caaf1021/Sala-Snoezelen/Sala.jpg

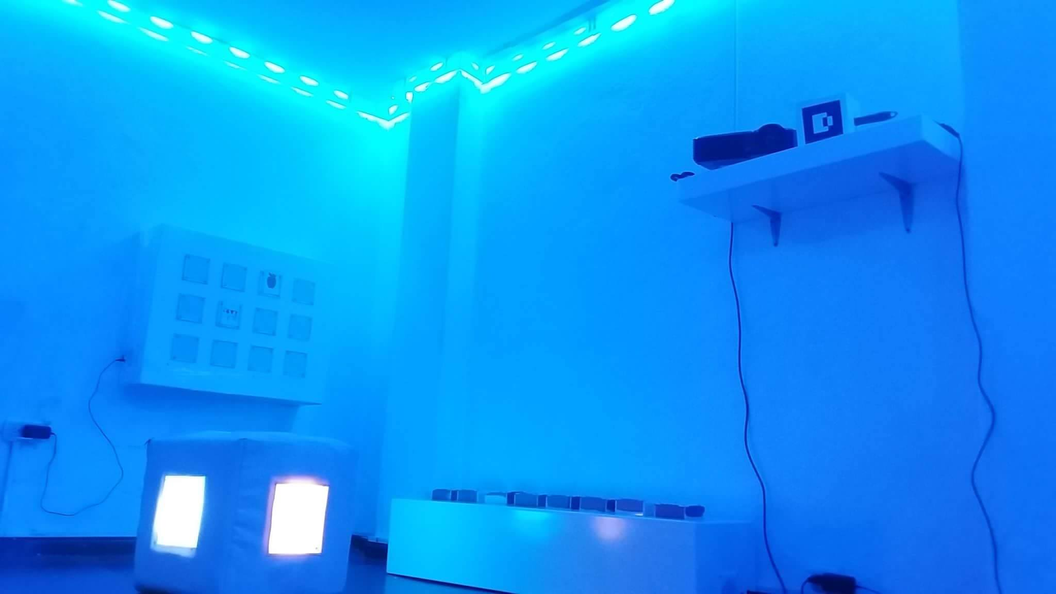
Sala.jpg
