caaf1021/Sala-Snoezelen/Tubo de Brillo/Tubo de Brillo.jpg

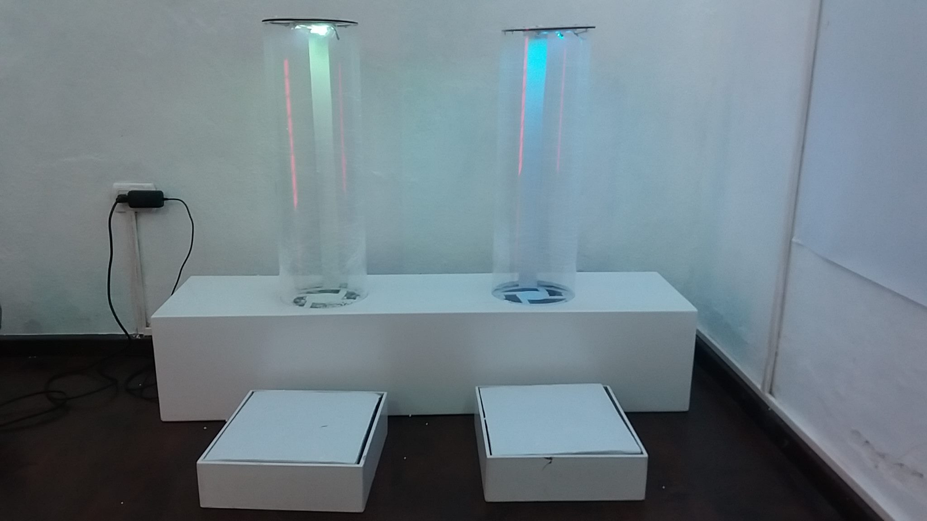
Tubo de Brillo/Tubo de Brillo.jpg
