caaf1021/Sala-Snoezelen/Vumetro/Complementos/Vumetro Escalera.pdf

PolyBoard 5.14e | 5/10/2017
vumetro caja
Página 1/6
Altura | 73.00 cm
Anchura | 49.00 cm
Profundidad 6.00 cm

PolyBoard 5.14e | 5/10/2017
vumetro caja
Página 2/6

## Lista de Corte (Dimensiones Totales)

Material Referencia Altura Anchura Cantidad Fibra Canto Izqu... Canto Der... Canto Infe... Canto Sup...
Mdf15, 1.40 Techo | 49.00 6.00 1 No
Mdf15, 1.40 Suelo | 49.00 6.00 1 No
Mdf15, 1.40 División 1 [... 70.20 6.00 2 No
Mdf15, 1.40 División 1 [... 37.16 6.00 7 No

## Resumen

Panel | Superficie Precio ($/sq ft) Precio
Mdf15, 1.40 3.22 sq ft | $0.00
Total | $0.00
Total | $0.00

PolyBoard 5.14e | | | 5/10/2017
vumetro caja
Página 3/6
Techo | Mdf15 | Altura: 49.00 Anchura: 6.00 Espesor: 1.40 | Cantidad: 1
| | Cara 1

6.00 49.00

PolyBoard 5.14e | | | 5/10/2017
vumetro caja
Página 4/6
Suelo | Mdf15 | Altura: 49.00 Anchura: 6.00 Espesor: 1.40 | Cantidad: 1
| | Cara 1

6.00 49.00

PolyBoard 5.14e | | 5/10/2017
vumetro caja
Página 5/6
División 1 [1], División 1 [2] Mdf15 | Altura: 70.20 Anchura: 6.00 Espesor: 1.40 | Cantidad: 2
Cara 1

6.00 70.20

PolyBoard 5.14e | 5/10/2017
vumetro caja
Página 6/6

División 1 [3], División 1 [4], División 1 [5], Di... Mdf15 Altura: 37.16 Anchura: 6.00 Espesor: 1.40 Cantidad: 7 Cara 1

6.00 37.16
