caaf1021/Sala-Snoezelen/Dado/Descripción.txt

El dado de colores nos permite configurar cada uno de sus lados de un color diferente, 
cambiará la iluminación de la Sala conforme el lado que al girar el dado quede en la 
parte superior.
