caaf1021/Sala-Snoezelen/Panel de Pictrogramas/Descripción.txt

Ayudará al niño a mejorar sus habilidades visuales, auditivas y táctiles, el panel contendrá un total 
de 12 pictogramas intercambiables, lo que permite desarrollar las sesiones de trabajo bajo diferentes 
categorías como figuras, colores y acciones (saltar, correr), permitiendo así escalabilidad del módulo, 
el cual contará con estímulos auditivos y visuales.
