caaf1021/Sala-Snoezelen/Módulo Central/Complementos/Nodo Central.pdf

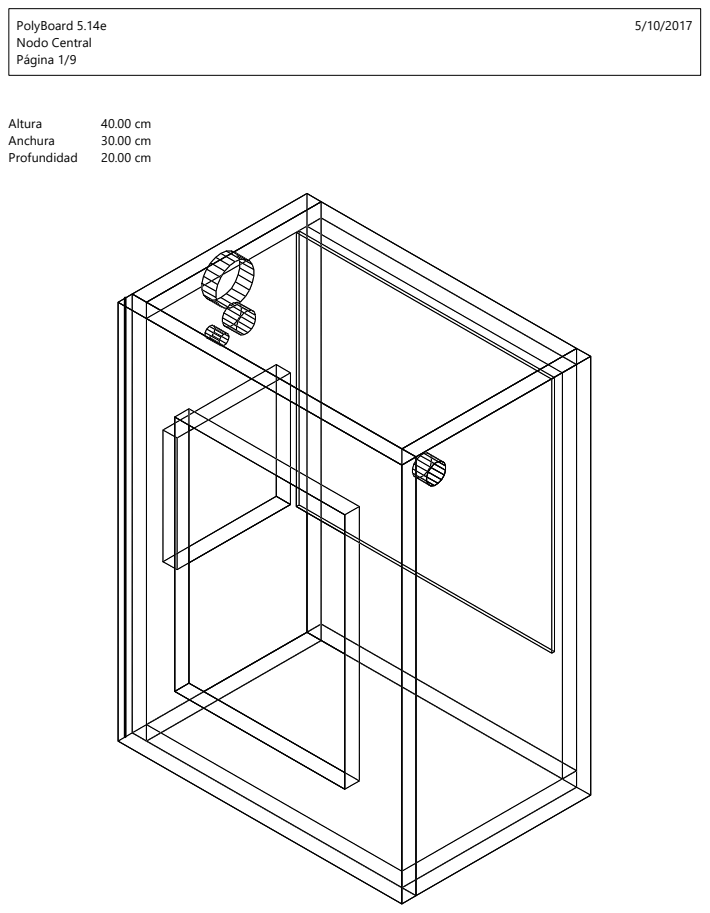
[picture p3: page 1]
PolyBoard 5.14e; Nodo Central Página 1/9; Altura; Anchura; Profundidad 20.00 cm

PolyBoard 5.14e | 5/10/2017
Nodo Central
Página 2/9

## Lista de Corte (Dimensiones Totales)

Material Referencia Altura Anchura Cantidad Fibra Canto Izqu... Canto Der... Canto Infe... Canto Sup...
Mdf15, 1.50 Techo | 27.00 18.50 1 No
Mdf15, 1.50 Suelo | 27.00 18.50 1 No
Mdf15, 1.50 Lateral Dere... 40.00 18.50 2 No
Mdf15, 1.50 Trasera 37.00 27.00 1 No Mdf3, 0.30 División 1 [1] 27.00 25.00 1 No Mdf15, 1.50 Puerta Unic... 40.00 30.00 1 No

## Resumen

Panel | Superficie Precio ($/sq ft) Precio
Mdf15, 1.50 5.04 sq ft | $0.00
Mdf3, 0.30 0.73 sq ft | $0.00
Total | $0.00
Total | $0.00

PolyBoard 5.14e | | | 5/10/2017
Nodo Central
Página 3/9
Techo | Mdf15 | Altura: 27.00 Anchura: 18.50 Espesor: 1.50 | Cantidad: 1
Cara 1

18.50 27.00

PolyBoard 5.14e | | | 5/10/2017
Nodo Central
Página 4/9
Suelo | Mdf15 | Altura: 27.00 Anchura: 18.50 Espesor: 1.50 | Cantidad: 1
Cara 1

18.50 27.00

PolyBoard 5.14e | | 5/10/2017
Nodo Central
Página 5/9
Lateral Derecho Mdf15 | Altura: 40.00 Anchura: 18.50 Espesor: 1.50 | Cantidad: 1

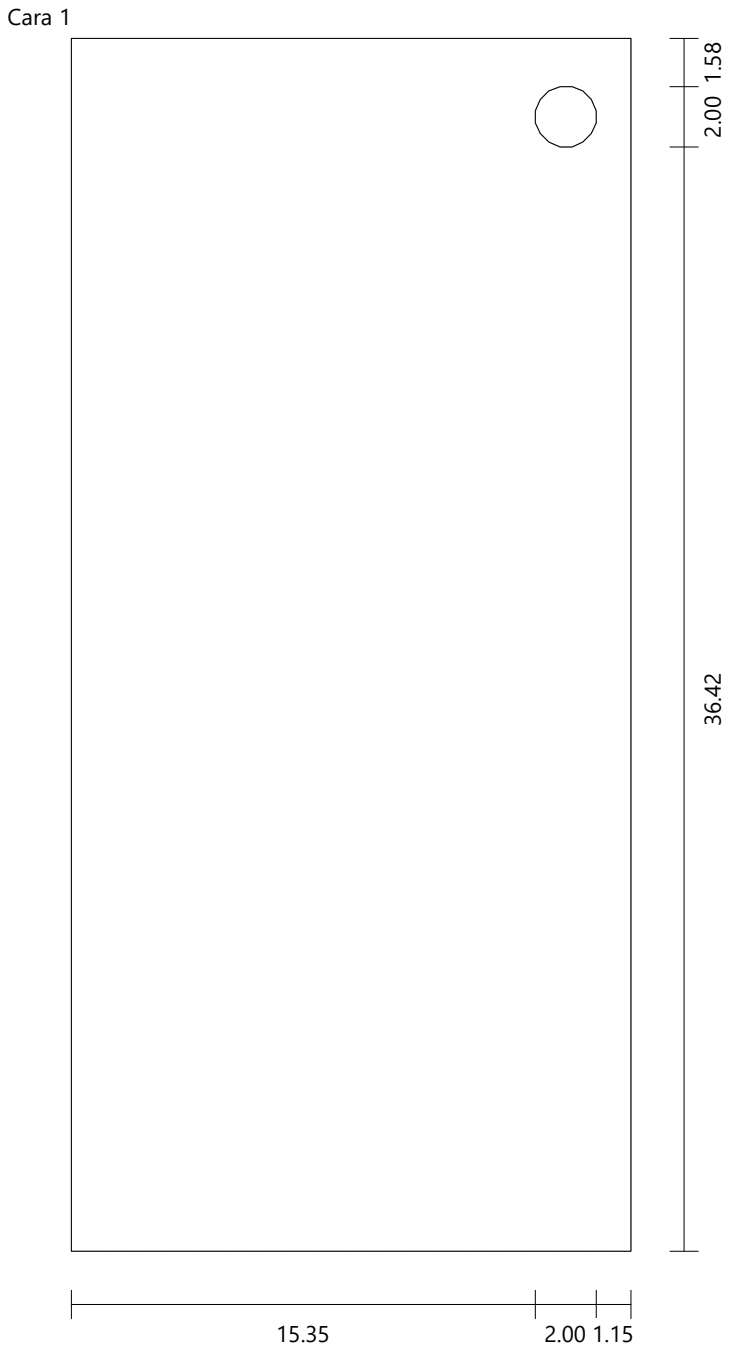
[picture p4: figure]
Cara 1

0.34 4.13 3.25 14.00 12.00 5.90 0.101.030.871.11 4.04 0.95

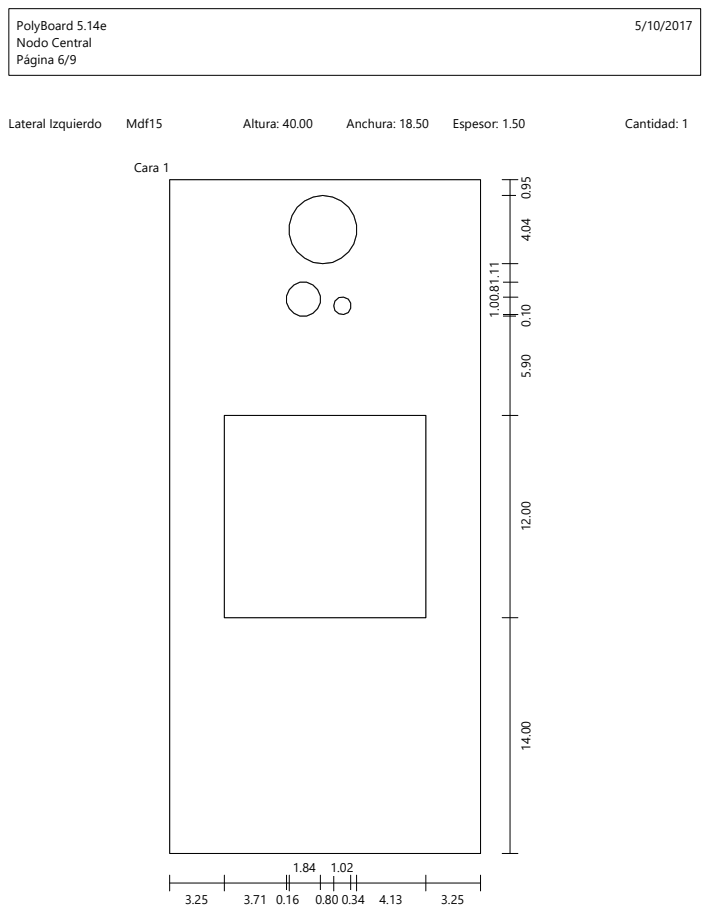
[picture p5: page 6]
PolyBoard 5.14e; Nodo Central Página 6/9; Lateral Izquierdo Mdf15; Altura: 40.00 Anchura: 18.50 Espesor: 1.50; Cantidad: 1; Cara 1

PolyBoard 5.14e | | | 5/10/2017
Nodo Central
Página 7/9
Trasera | Mdf15 | Altura: 37.00 Anchura: 27.00 Espesor: 1.50 | Cantidad: 1
Cara 1

27.00 37.00

PolyBoard 5.14e | | | 5/10/2017
Nodo Central
Página 8/9
División 1 [1] | Mdf3 | Altura: 27.00 Anchura: 25.00 Espesor: 0.30 | Cantidad: 1
Cara 1

25.00 27.00

PolyBoard 5.14e | 5/10/2017
Nodo Central
Página 9/9
Puerta Unica [1] Mdf15 | Altura: 40.00 Anchura: 30.00 Espesor: 1.50 | Cantidad: 1
Cara 1
6.00 | 18.00 | 6.00 | 7.50 25.00 7.50
