caaf1021/Sala-Snoezelen/Panel de Pictrogramas/Complementos/Panel Pictogramas.pdf

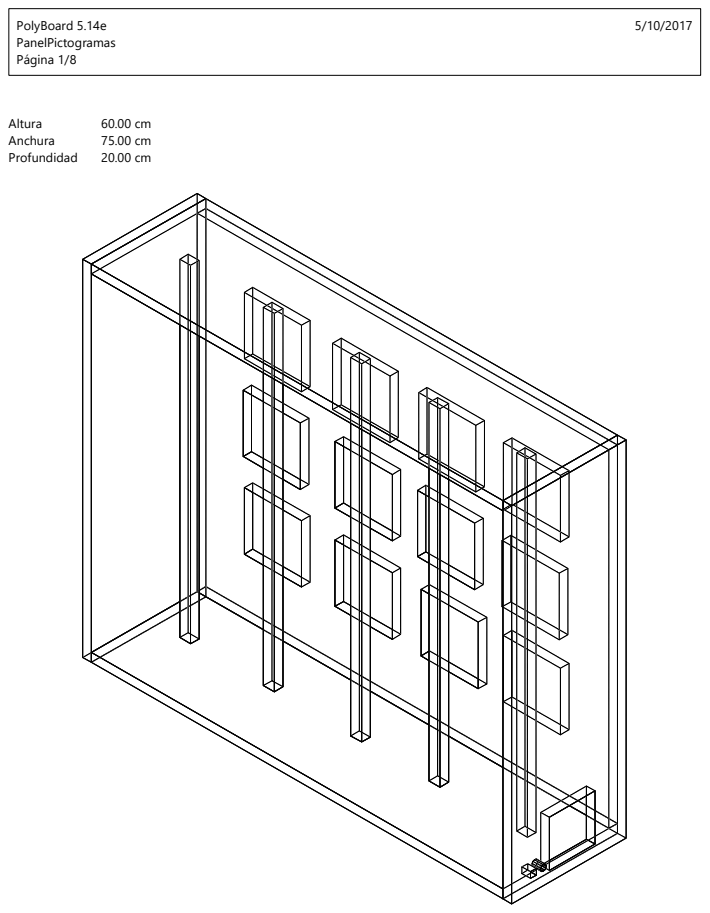
[picture p6: page 1]
PolyBoard 5.14e; PanelPictogramas Página 1/8; Altura; Anchura; Profundidad 20.00 cm

PolyBoard 5.14e | 5/10/2017
PanelPictogramas
Página 2/8

## Lista de Corte (Dimensiones Totales)

Material Referencia Altura Anchura Cantidad Fibra Canto Izqu... Canto Der... Canto Infe... Canto Sup...
Mdf15, 1.50 Techo | 72.00 20.00 1 No
Mdf15, 1.50 Suelo | 72.00 20.00 1 No
Mdf15, 1.50 Lateral [1], ... 60.00 20.00 2 No
Mdf15, 1.50 Trasera [1] 57.00 72.00 1 No MELA_BL, 1.... División 1 [... 57.00 1.50 5 No

## Resumen

Panel | Superficie Precio ($/sq ft) Precio
Mdf15, 1.50 10.10 sq ft | $0.00
MELA_BL, 1.90 0.46 sq ft | 0.93 $0.43
Total | $0.43
Total | $0.43

PolyBoard 5.14e | | | 5/10/2017
PanelPictogramas
Página 3/8
Techo | Mdf15 | Altura: 72.00 Anchura: 20.00 Espesor: 1.50 | Cantidad: 1
Cara 1

20.00 72.00

PolyBoard 5.14e | | | 5/10/2017
PanelPictogramas
Página 4/8
Suelo | Mdf15 | Altura: 72.00 Anchura: 20.00 Espesor: 1.50 | Cantidad: 1
Cara 1

20.00 72.00

PolyBoard 5.14e | | | 5/10/2017
PanelPictogramas
Página 5/8
Lateral [1] | Mdf15 | Altura: 60.00 Anchura: 20.00 Espesor: 1.50 | Cantidad: 1

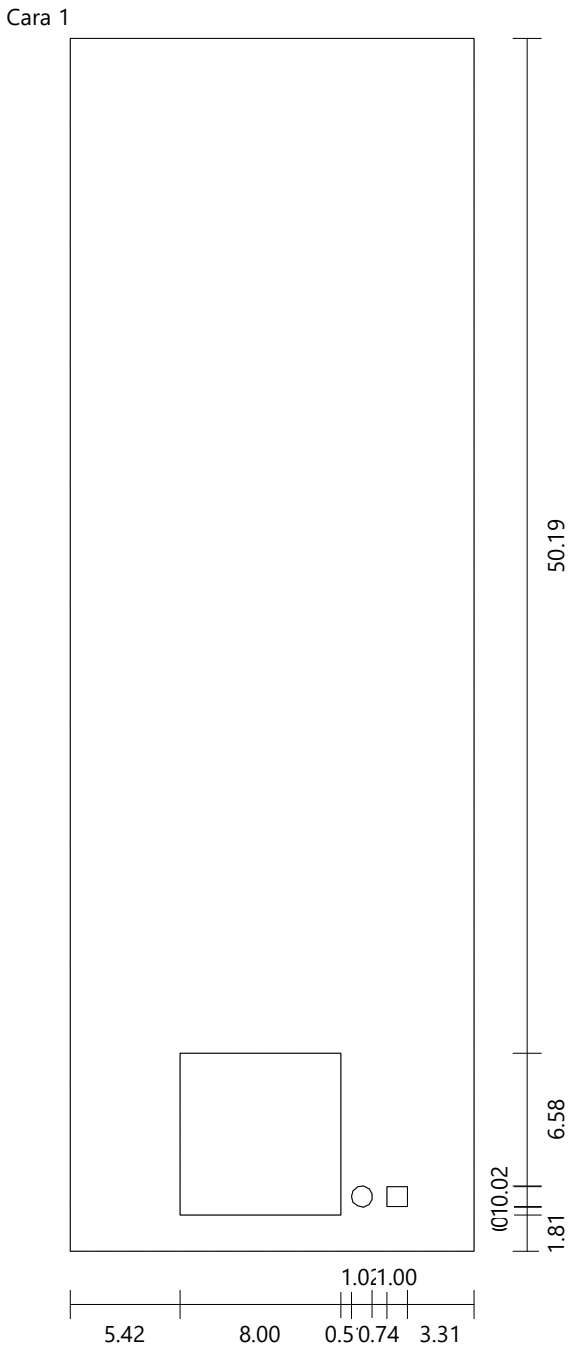
[picture p7: figure]
Cara 1

PolyBoard 5.14e | | | 5/10/2017
PanelPictogramas
Página 6/8
Lateral [2] | Mdf15 | Altura: 60.00 Anchura: 20.00 Espesor: 1.50 | Cantidad: 1
Cara 1

20.00 60.00

PolyBoard 5.14e | | | 5/10/2017
PanelPictogramas
Página 7/8
Trasera [1] | Mdf15 | Altura: 57.00 Anchura: 72.00 Espesor: 1.50 | Cantidad: 1

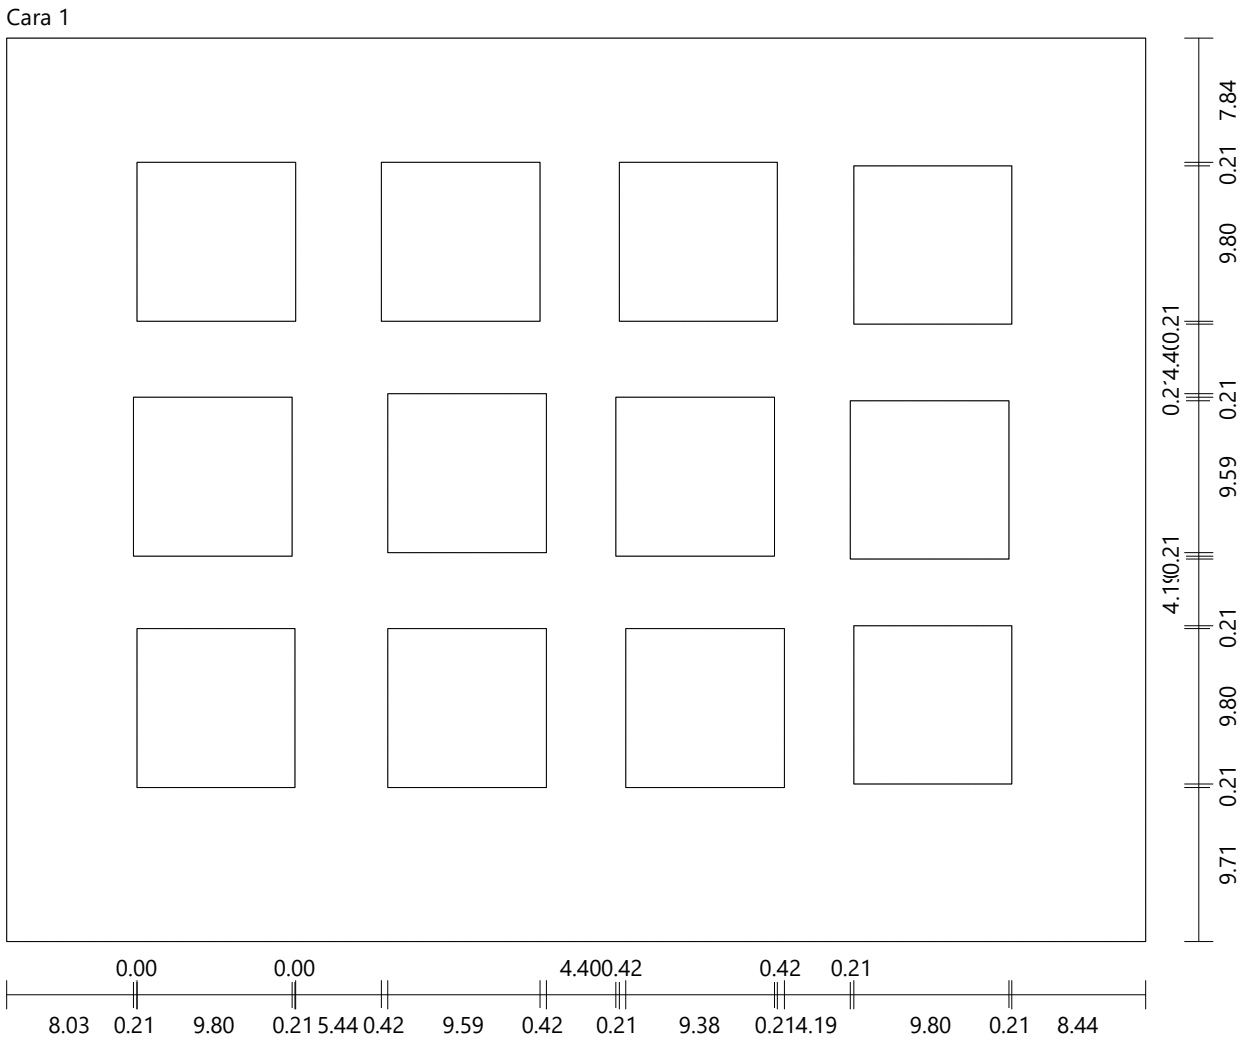
[picture p8: figure]
Cara 1

| | 9.80 0.21 8.44 | 9.71 0.21 9.80 0.214.190.21 9.59 0.21 0.214.400.21 9.80 0.21 7.84

PolyBoard 5.14e | 5/10/2017
PanelPictogramas
Página 8/8

División 1 [1], División 1 [2], División 1 [3], Di... MELA_BL Altura: 57.00 Anchura: 1.50 Espesor: 1.90 Cantidad: 5 Cara 1

1.50 57.00
