caaf1021/Sala-Snoezelen/Piano de Luces/Complementos/Piano Luces.pdf

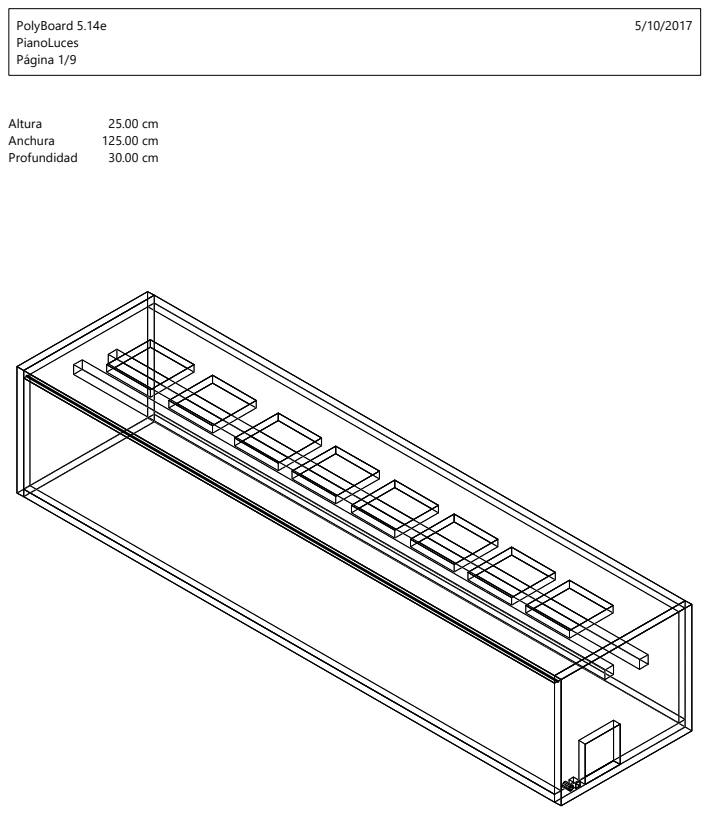
[picture p9: page 1]
PolyBoard 5.14e; PianoLuces Página 1/9; Altura; Anchura; Profundidad 30.00 cm

PolyBoard 5.14e | 5/10/2017
PianoLuces
Página 2/9

## Lista de Corte (Dimensiones Totales)

Material Referencia Altura Anchura Cantidad Fibra Canto Izqu... Canto Der... Canto Infe... Canto Sup...
Mdf15, 1.50 Techo | 122.00 30.00 1 No
Mdf15, 1.50 Suelo | 122.00 30.00 1 No
Mdf15, 1.50 Lateral Der... 25.00 30.00 2 No
Mdf15, 1.50 Trasera 22.00 122.00 1 No PLW_305, 1... Estante Fijo... 122.00 2.00 2 No Mdf15, 1.50 Puerta Unic... 22.00 122.00 1 No

## Resumen

Panel | Superficie Precio ($/sq ft) Precio
Mdf15, 1.50 15.27 sq ft | $0.00
PLW_305, 1.90 0.53 sq ft | 0.93 $0.49
Total | $0.49
Total | $0.49

PolyBoard 5.14e | | | 5/10/2017
PianoLuces
Página 3/9
Techo | Mdf15 | Altura: 122.00 Anchura: 30.00 Espesor: 1.50 | Cantidad: 1
Cara 1
9.27 10.02 10.71 8.41 10.02 4.29 10.02 5.01 10.02 3.22 10.02 3.58 10.02 3.58 10.02 3.22 10.02 3.22 10.02 7.33

PolyBoard 5.14e | | | 5/10/2017
PianoLuces
Página 4/9
Suelo | Mdf15 | Altura: 122.00 Anchura: 30.00 Espesor: 1.50 | Cantidad: 1
Cara 1

30.00 122.00

PolyBoard 5.14e | | 5/10/2017
PianoLuces
Página 5/9
Lateral Derecho Mdf15 | Altura: 25.00 Anchura: 30.00 Espesor: 1.50 | Cantidad: 1

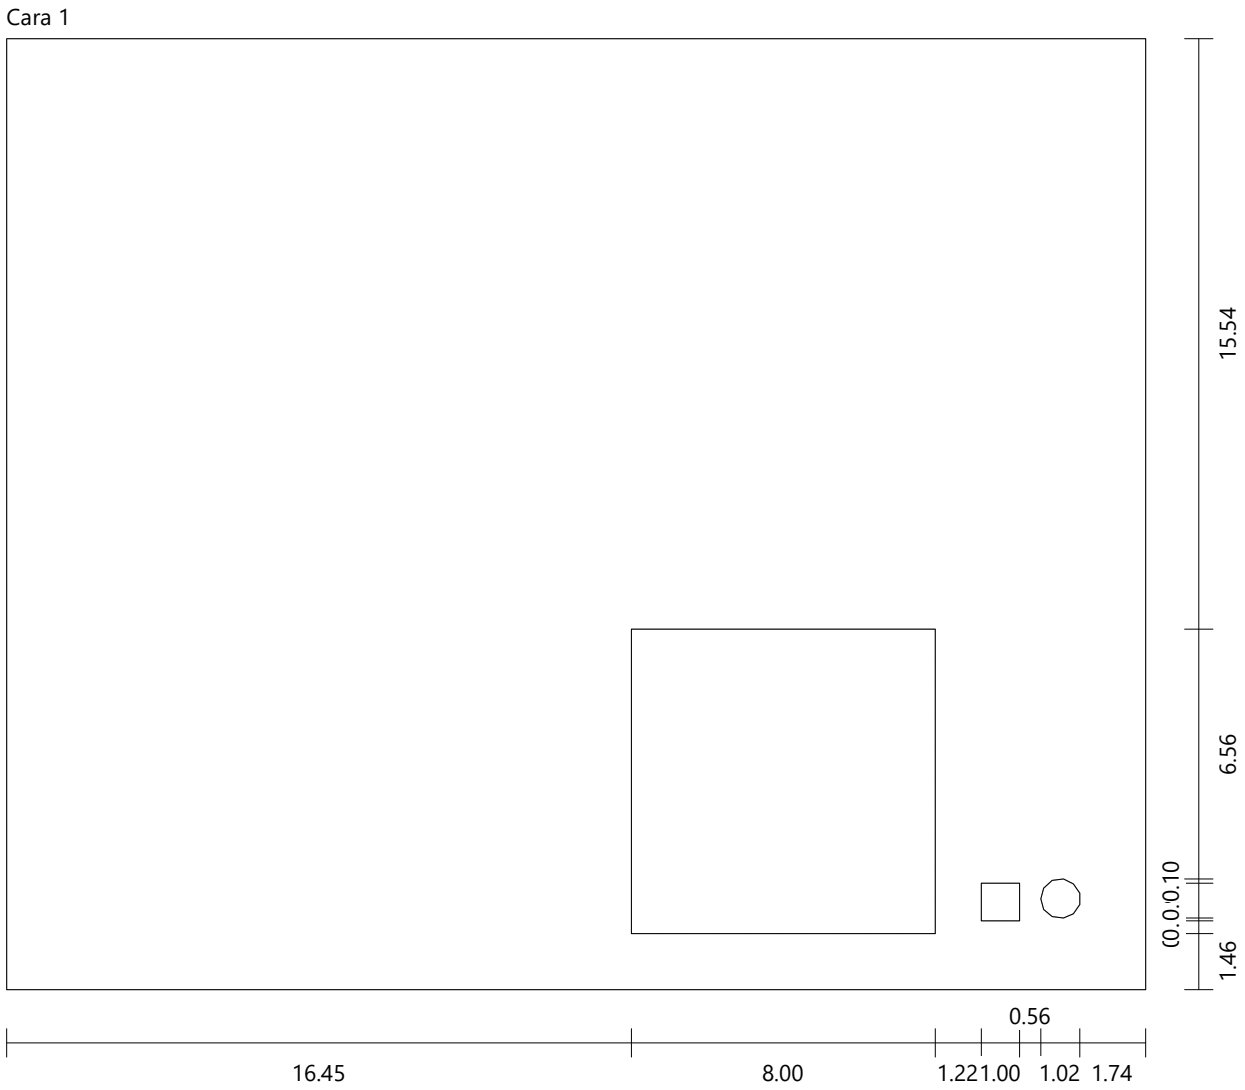
[picture p10: figure]
Cara 1

1.02 1.74 | 1.460.33 0.070.930.10 6.56 15.54

PolyBoard 5.14e | | 5/10/2017
PianoLuces
Página 6/9
Lateral Izquierdo Mdf15 | Altura: 25.00 Anchura: 30.00 Espesor: 1.50 | Cantidad: 1

Cara 1

30.00 25.00

PolyBoard 5.14e | | | 5/10/2017
PianoLuces
Página 7/9
Trasera | Mdf15 | Altura: 22.00 Anchura: 122.00 Espesor: 1.50 | Cantidad: 1

Cara 1

122.00 22.00

PolyBoard 5.14e | 5/10/2017
PianoLuces
Página 8/9

Estante Fijo [1], Estante Fijo [2] PLW_305 Altura: 122.00 Anchura: 2.00 Espesor: 1.90 Cantidad: 2 Cara 1

2.00 122.00

PolyBoard 5.14e | | 5/10/2017
PianoLuces
Página 9/9
Puerta Unica [1] Mdf15 | Altura: 22.00 Anchura: 122.00 Espesor: 1.50 | Cantidad: 1

Cara 1

122.00 22.00
