caaf1021/Sala-Snoezelen/Tubo de Brillo/Complementos/Tubo Brillo.pdf

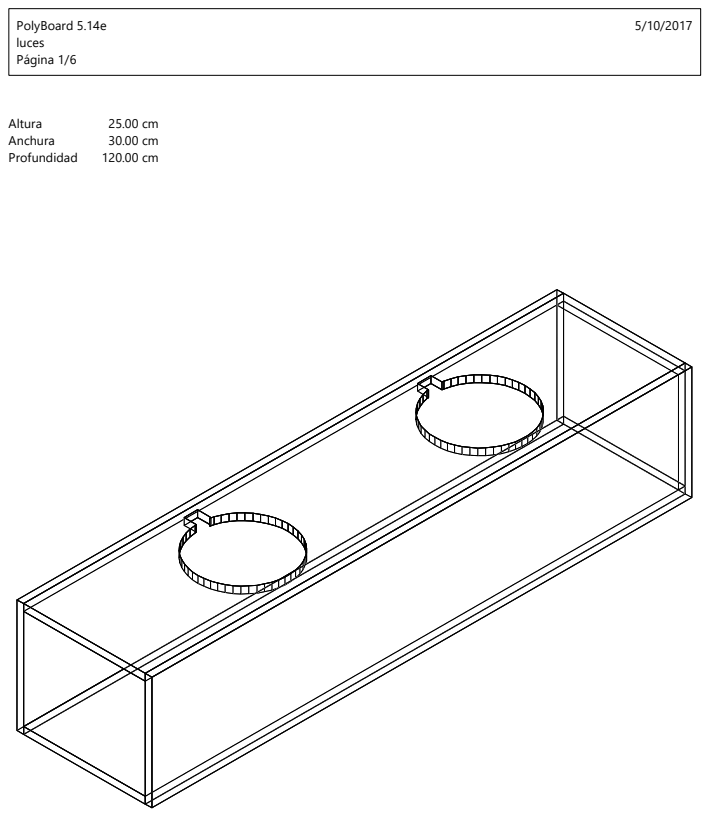
[picture p11: page 1]
PolyBoard 5.14e; luces Página 1/6; Altura; Anchura; Profundidad 120.00 cm

PolyBoard 5.14e | 5/10/2017
luces
Página 2/6

## Lista de Corte (Dimensiones Totales)

Material Referencia Altura Anchura Cantidad Fibra Canto Izqu... Canto Der... Canto Infe... Canto Sup...
Mdf15, 1.50 Techo | 27.00 120.00 1 No
Mdf15, 1.50 Suelo | 27.00 120.00 1 No
Mdf15, 1.50 Lateral Dere... 25.00 120.00 2 No
Mdf15, 1.50 Trasera 22.00 27.00 1 No

## Resumen

Panel | Superficie Precio ($/sq ft) Precio
Mdf15, 1.50 14.07 sq ft | $0.00
Total | $0.00
Total | $0.00

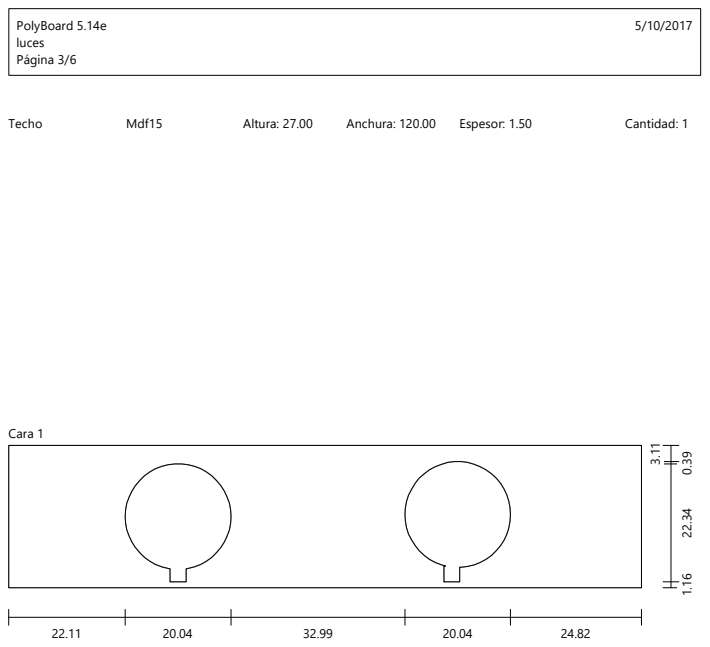
[picture p12: page 3]
PolyBoard 5.14e; luces Página 3/6; Techo; Mdf15; Altura: 27.00 Anchura: 120.00 Espesor: 1.50; Cantidad: 1; Cara 1

PolyBoard 5.14e | | | 5/10/2017
luces
Página 4/6
Suelo | Mdf15 | Altura: 27.00 Anchura: 120.00 Espesor: 1.50 | Cantidad: 1

Cara 1

120.00 27.00

PolyBoard 5.14e | 5/10/2017
luces
Página 5/6

Lateral Derecho, Lateral Izquierdo Mdf15 Altura: 25.00 Anchura: 120.00 Espesor: 1.50 Cantidad: 2

Cara 1

120.00 25.00

PolyBoard 5.14e | | | 5/10/2017
luces
Página 6/6
Trasera | Mdf15 | Altura: 22.00 Anchura: 27.00 Espesor: 1.50 | Cantidad: 1

Cara 1

27.00 22.00
