caaf1021/Sala-Snoezelen/Vumetro/Complementos/Vumetro Carcasa.pdf

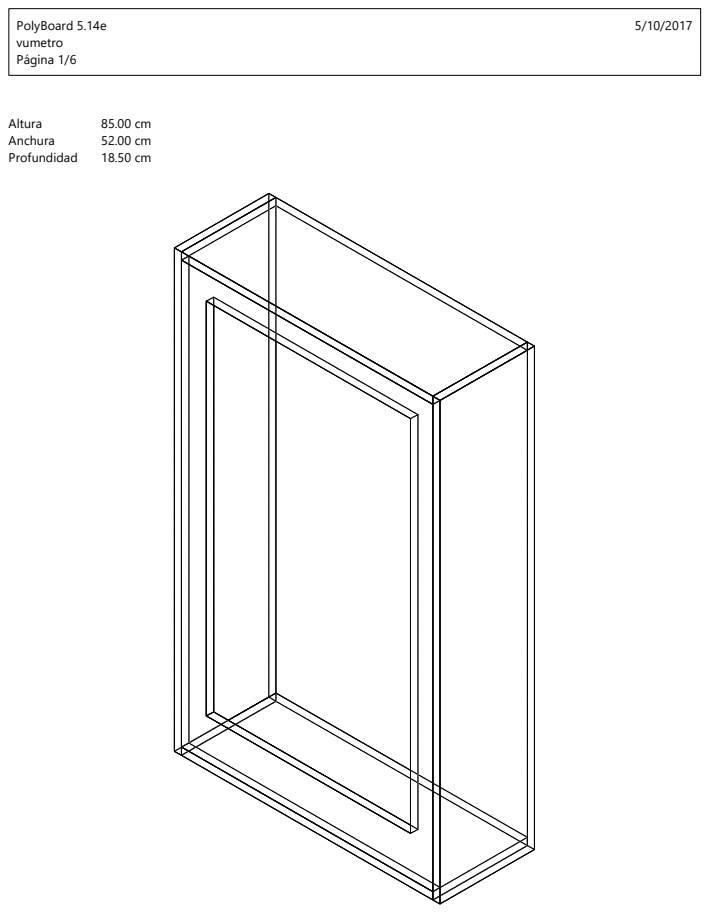
[picture p13: page 1]
PolyBoard 5.14e; vumetro Página 1/6; Altura; Anchura; Profundidad 18.50 cm

PolyBoard 5.14e | 5/10/2017
vumetro
Página 2/6

## Lista de Corte (Dimensiones Totales)

Material Referencia Altura Anchura Cantidad Fibra Canto Izqu... Canto Der... Canto Infe... Canto Sup...
Mdf15, 1.40 Techo | 49.20 18.50 1 No
Mdf15, 1.40 Suelo | 49.20 18.50 1 No
Mdf15, 1.40 Lateral Dere... 85.00 18.50 2 No
Mdf15, 1.40 Trasera 82.20 49.20 1 No

## Resumen

Panel | Superficie Precio ($/sq ft) Precio
Mdf15, 1.40 9.70 sq ft | $0.00
Total | $0.00
Total | $0.00

PolyBoard 5.14e | | | 5/10/2017
vumetro
Página 3/6
Techo | Mdf15 | Altura: 49.20 Anchura: 18.50 Espesor: 1.40 | Cantidad: 1
Cara 1

18.50 49.20

PolyBoard 5.14e | | | 5/10/2017
vumetro
Página 4/6
Suelo | Mdf15 | Altura: 49.20 Anchura: 18.50 Espesor: 1.40 | Cantidad: 1
Cara 1

18.50 49.20

PolyBoard 5.14e | 5/10/2017
vumetro
Página 5/6

Lateral Derecho, Lateral Izquierdo Mdf15 Altura: 85.00 Anchura: 18.50 Espesor: 1.40 Cantidad: 2 Cara 1

18.50 85.00

PolyBoard 5.14e | 5/10/2017
vumetro
Página 6/6
Trasera | Mdf15 | Altura: 82.20 Anchura: 49.20 Espesor: 1.40 | Cantidad: 1
Cara 1
4.34 | 40.00 | 4.86 | 7.67 70.00 4.53
