caaf1021/Sala-Snoezelen/Dado/Dado.jpg

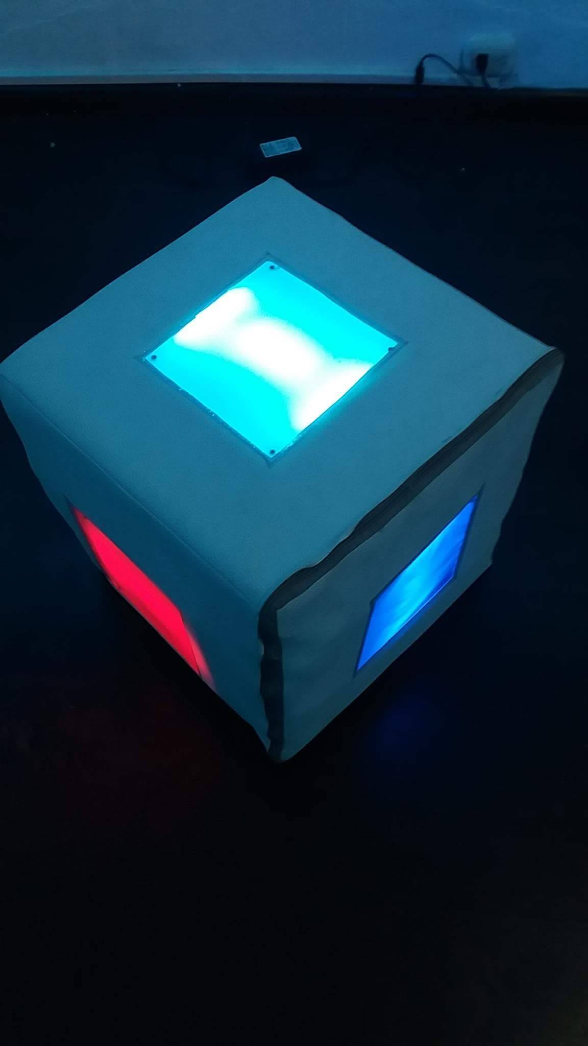
Dado/Dado.jpg
