caaf1021/Sala-Snoezelen/Módulo Central/Módulo Central.jpg

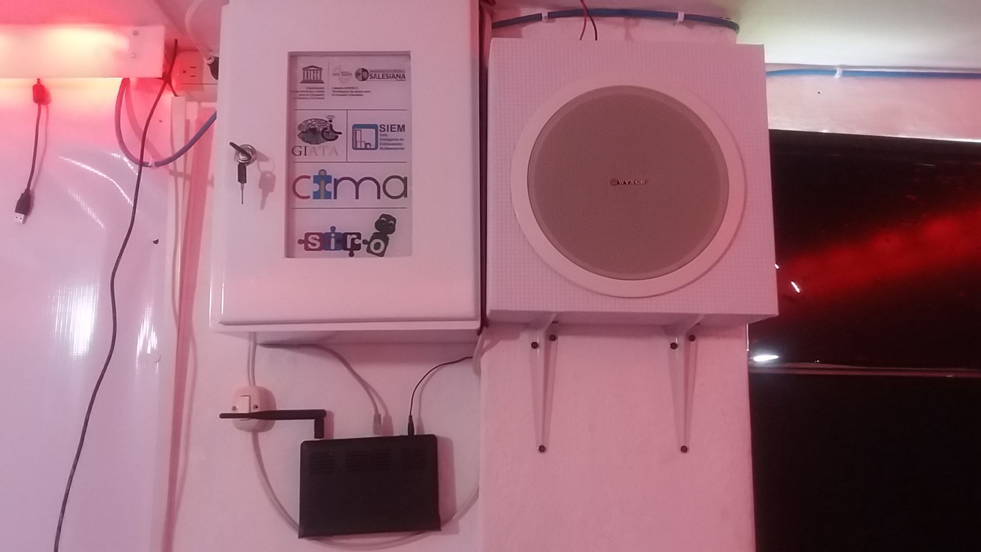
Módulo Central/Módulo Central.jpg
