caaf1021/Sala-Snoezelen/Panel de Pictrogramas/Panel de Pictogramas.jpg

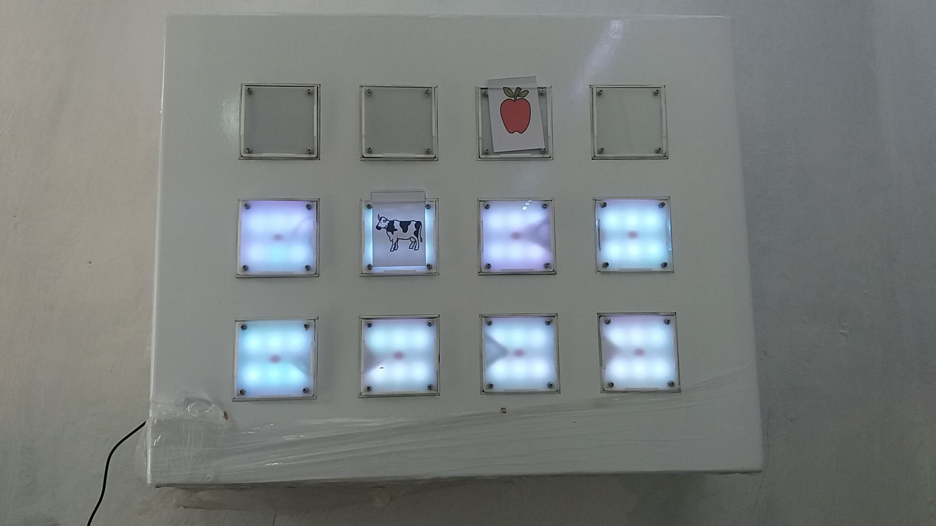
Panel de Pictrogramas/Panel de Pictogramas.jpg
