caaf1021/Sala-Snoezelen/Piano de Luces/Piano  de Luces.jpg

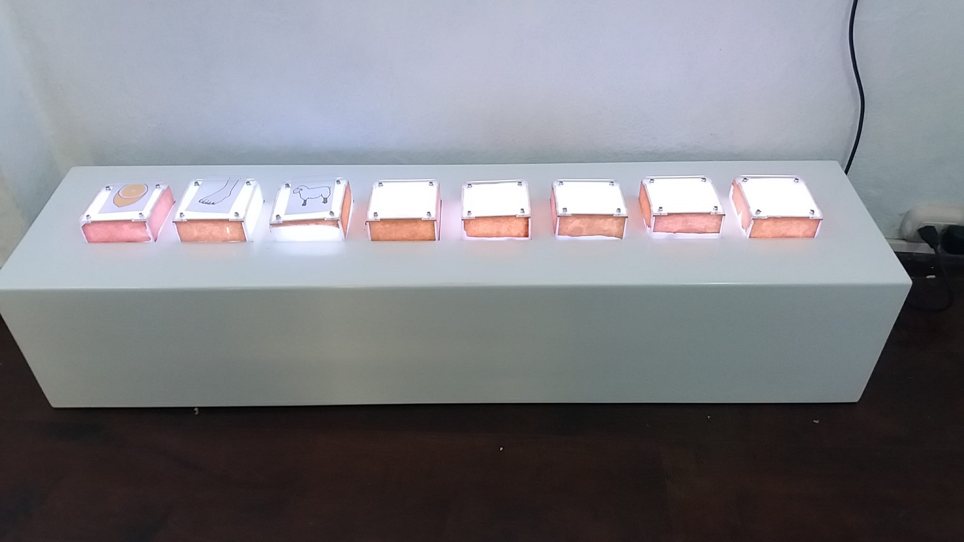
Piano de Luces/Piano de Luces.jpg
