caaf1021/Sala-Snoezelen/Vumetro/Vumetro.jpg

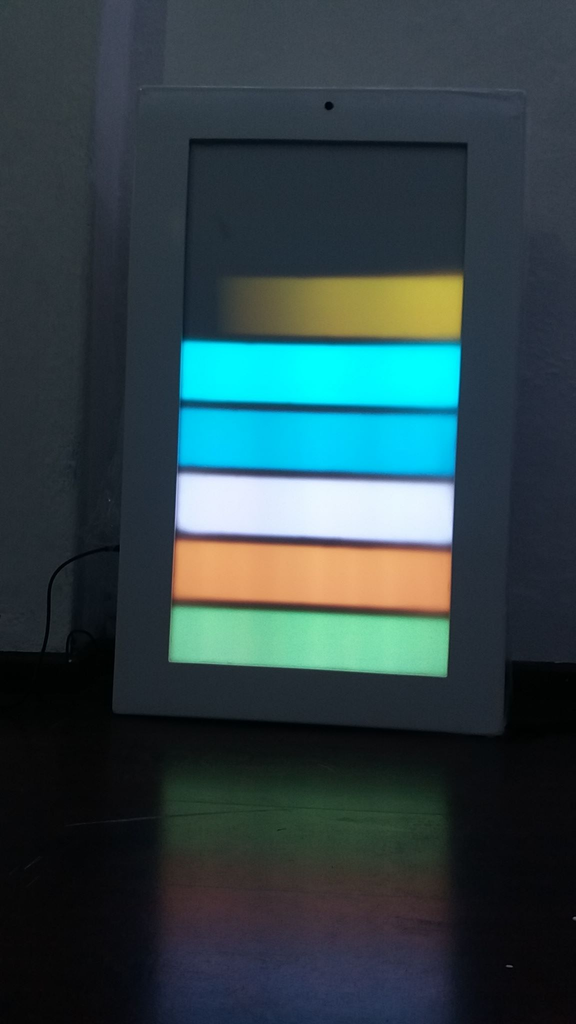
Vumetro/Vumetro.jpg
