caaf1021/Sala-Snoezelen/(list of files, drawings)

Other design files:
Dado/Complementos/control dado.pdsprj
Módulo Central/Complementos/Sala iluminación.pdsprj
Panel de Pictrogramas/Complementos/pulsante panel.pdsprj
Piano de Luces/Complementos/pulsante piano.pdsprj
Tubo de Brillo/Complementos/tubo de brillo.pdsprj
Vumetro/Complementos/Vumetro.pdsprj
